arthur-wirjo/ICE_end-of-arm_tooling_controller/BOM_and_Schematics/BOM.md

### EOAT Controller Board BOM

| Category | Description / Value | Manufacturer & Part Number | LCSC / Part ID | Designator | Qty |
| :--- | :--- | :--- | :--- | :--- | :--- |
| **Resistors** | 100Ω, 0603, 1%, 100mW | FOJAN FRC0603F1000TS | C2906981 | R11, R12, R18, R24 | 4 |
| | 1kΩ, 0603, 1%, 100mW | FOJAN FRC0603F1001TS | C2907002 | R1, R2, R6–R9, R19, R20, R29–R31 | 11 |
| | 5.1kΩ, 0805, 1%, 125mW | FOJAN FRC0805F5101TS | C2907269 | R3, R4, R17, R32 | 4 |
| | 10kΩ, 0603, 1%, 100mW | FOJAN FRC0603F1002TS | C2906982 | R13, R14, R21, R33 | 4 |
| | 13.3kΩ, 0603, 1%, 100mW | FOJAN FRC0603F1332TS | C2933140 | R16, R28 | 2 |
| | 100kΩ, 0603, 1%, 100mW | FOJAN FRC0603F1003TS | C2906980 | R5, R10, R15, R22, R23, R26, R27 | 7 |
| | 0.05Ω, 1206, 1%, 1W (Shunt) | FOJAN FRM121WFR050TM | C7467249 | R25 | 1 |
| **Capacitors** | 100nF, 0603, 50V, X7R, 10% | FOJAN FCC0603B104K500CT | C5137636 | C2–C4, C8, C9, C11–C15, C18 | 11 |
| | 1uF, 0603, 25V, X7R, 10% | Samsung Electro-Mechanics CL10B105KA8NNNC | C29936 | C19, C20 | 2 |
| | 4.7uF, 0805, 25V, X7R, 10% | Samsung Electro-Mechanics CL21B475KAFNNNE | C98195 | C6 | 1 |
| | 10uF, 1206, 50V, X7R, 10% | Samsung Electro-Mechanics CL31B106KBHNNNE | C89632 | C1, C10 | 2 |
| | 22uF, 1206, 35V, X5R, 20% | FOJAN FCC1206X226M350HT | C46635923 | C5, C7, C16, C17 | 4 |
| **Inductors** | 15uH, 7.5x6.8mm, 5A, 5.5A (Isat), 54mΩ | FANGCHENG FCH0650-150M | C20415538 | L1, L2 | 2 |
| **Diodes & LEDs** | TVS Diode, Bidirectional, VRWM=26V, Vc=42.1V | Littelfuse SMBJ26CA | C83332 | D11 | 1 |
| | Schottky Diode, 60V, 5A | MDD SS56 | C65009 | D5, D6 | 2 |
| | Red LED, 0603, Vf=2.3V, 20mA, 225mcd | XINGLIGHT XL-1608SURC-06 | C965799 | D7 | 1 |
| | Green LED, 0603, Vf=2.7~3.2V, 25mA, 358mcd | YONGYUTAI YLED0603G | C19273151 | D8, D9, D10, D12 | 4 |
| | Blue LED, 0603, Vf=2.6~3.3V, 5mA, 300mcd | XINGLIGHT XL-1608UBC-06A | C7371904 | D1, D2, D3, D4 | 4 |
| **ICs** | Microcontroller | ST STM32G030F6P6TR | C529330 | U7 | 1 |
| | Buck Converter | TI LMR16030SDDAR | C136648 | U1, U8 | 2 |
| | LDO | MICRONE ME6211A33PG-N | C236673 | U10 | 1 |
| | Optocoupler | TOSHIBA TLP291(GB-TP,SE) | C55144 | U2, U3, U4, U5 | 4 |
| | Voltage Translator | TI SN74LVC1T45DBVR | C7843 | U6 | 1 |
| | Current Sense Amplifier | TI INA180A1IDBVR | C122228 | U9 | 1 |
| **Connectors** | JST-XH 6-pin | JST S6B-XH-SM4-TB(LF)(SN) | - | - | 1 |
| | ST-Link 2.54mm 5-pin | 1x5P 2.54mm Pin Header | - | - | 1 |
| | PWM Servo Output 2.54mm 3-pin | 1x3P 2.54mm Pin Header | - | - | 1 |
| | Digital Servo Output Molex 3-pin | Hongxing HX25003-3WAP | C442327 | - | 1 |
| **Switches** | MCU nRST and BOOT0 Tactile Buttons | XKB Connection TS-1187A-B-A-B | C318884 | - | 2 |

### Off-Board Components (Cables)

| Category | Description / Value | Qty |
| :--- | :--- | :--- |
| **Cables** | M8 6-pin Male Aviation Connector Cable | 1 |
| | XH 2.54mm pitch single-sided, 22AWG Cable | 1 |
