arthur-wirjo/ICE_end-of-arm_tooling_controller/BOM_and_Schematics/ICE_EOAT_Controller_PCB.csv

Reference | Qty | Value | Description | Manufacturer | MPN | LCSC | Footprint
C1, C10 | 2 | 10uF | 1206, 50V, X7R, 10% | Samsung Electro-Mechanics | CL31B106KBHNNNE | C89632 | C_1206_3216Metric
C2, C3, C4, C8, C9, C11, C12, C13, C14, C15, C18 | 11 | 100nF | 0603, 50V, X7R, 10% | FOJAN | FCC0603B104K500CT | C5137636 | C_0603_1608Metric
C5, C7, C16, C17 | 4 | 22uF | 1206, 35V, X5R, 20% | FOJAN | FCC1206X226M350HT | C46635923 | C_1206_3216Metric
C6 | 1 | 4.7uF | 0805, 25V, X7R, 10% | Samsung Electro-Mechanics | CL21B475KAFNNNE | C98195 | C_0805_2012Metric
C19, C20 | 2 | 1uF | 0603, 25V, X7R, 10% | Samsung Electro-Mechanics | CL10B105KA8NNNC | C29936 | C_0603_1608Metric
CN1 | 1 | HX25003-3WAP | Digital Servo Output 3-Pin Right-Angle Header, 2.50mm Pitch, THT | Hongxing | HX25003-3WAP | C442327 | MOLEX_CONN-TH_3P-P2.50_HX25003-3WAP
D1, D2, D3, D4 | 4 | Blue | Blue SMD LED, 0603, Vf=2.6~3.3V, 5mA, 300mcd | XINGLIGHT | XL-1608UBC-06A | C7371904 | LED_0603_1608Metric
D5, D6 | 2 | SS56 | Schottky Diode, 60V, 5A, SMA | MDD | SS56 | C65009 | Schottky_SMA_L4.3-W2.6-LS5.2-RD
D7 | 1 | Red | Red SMD LED, 0603, Vf=2.3V, 20mA, 225mcd | XINGLIGHT | XL-1608SURC-06 | C965799 | LED_0603_1608Metric
D8, D9, D10, D12 | 4 | Green | Green SMD LED, 0603, Vf=2.7~3.2V, 25mA, 358mcd | YONGYUTAI | YLED0603G | C19273151 | LED_0603_1608Metric
D11 | 1 | SMBJ26CA | TVS Diode, Bidirectional, VRWM=26V, Vc=42.1V, DO-214AA (SMB) | Littelfuse | SMBJ26CA | C83332 | TVS_SMB_L4.6-W3.6-LS5.3-BI
J1 | 1 | S6B-XH-SM4-TB(LF)(SN) | JST-XH 6-Pin Male Header, Right-Angle SMD | JST | S6B-XH-SM4-TB(LF)(SN) | - | JST_XH_CONN_S6B-XH-SM4-TB_JST
J2 | 1 | 2.54mm 5-pin | ST-Link 1x5P 2.54mm Pitch Male Pin Header, Horizontal | Generic | - | - | PinHeader_1x05_P2.54mm_Horizontal
J3 | 1 | 2.54mm 3-pin | PWM Servo Output 1x3P 2.54mm Pitch Male Pin Header, Horizontal | Generic | - | - | PinHeader_1x03_P2.54mm_Horizontal
L1, L2 | 2 | 15uH | Shielded Power Inductor, 7.5x6.8mm, 5A, Isat 5.5A, 54mΩ | FANGCHENG | FCH0650-150M | C20415538 | INDUCTOR_IND-SMD_L7.6-W7.0
R1, R2, R6, R7, R8, R9, R19, R20, R29, R30, R31 | 11 | 1kΩ | 0603, 1%, 100mW | FOJAN | FRC0603F1001TS | C2907002 | R_0603_1608Metric
R3, R4, R17, R32 | 4 | 5.1kΩ | 0805, 1%, 125mW | FOJAN | FRC0805F5101TS | C2907269 | R_0805_2012Metric
R5, R10, R15, R22, R23, R26, R27 | 7 | 100kΩ | 0603, 1%, 100mW | FOJAN | FRC0603F1003TS | C2906980 | R_0603_1608Metric
R11, R12, R18, R24 | 4 | 100Ω | 0603, 1%, 100mW | FOJAN | FRC0603F1000TS | C2906981 | R_0603_1608Metric
R13, R14, R21, R33 | 4 | 10kΩ | 0603, 1%, 100mW | FOJAN | FRC0603F1002TS | C2906982 | R_0603_1608Metric
R16, R28 | 2 | 13.3kΩ | 0603, 1%, 100mW | FOJAN | FRC0603F1332TS | C2933140 | R_0603_1608Metric
R25 | 1 | 0.05Ω | Current Sense Shunt Resistor, 1206, 1%, 1W | FOJAN | FRM121WFR050TM | C7467249 | Shunt_R1206
SW1, SW2 | 2 | TS-1187A-B-A-B | MCU nRST and BOOT0 Tactile Switch, SPST, SMD-4P, 5.1x5.1x1.5mm | XKB Connection | TS-1187A-B-A-B | C318884 | BUTTON_SW-SMD_4P-L5.1-W5.1
U1, U8 | 2 | LMR16030SDDAR | 60V, 3A Step-Down Buck Converter, HSOIC-8-EP | Texas Instruments | LMR16030SDDAR | C136648 | BUCK_SOIC-8_EP
U2, U3, U4, U5 | 4 | TLP291(GB-TP,SE) | Optocoupler, Phototransistor Output, 3.75kVrms, SOP-4 | TOSHIBA | TLP291(GB-TP,SE) | C55144 | Optocoupler_SOP-4
U6 | 1 | SN74LVC1T45DBVR | Single-Bit Dual-Supply Bus Transceiver / Level Shifter, SOT-23-6 | Texas Instruments | SN74LVC1T45DBVR | C7843 | Voltage_Translator_SOT-23-6
U7 | 1 | STM32G030F6P6TR | 32-bit ARM Cortex-M0+ MCU, 64MHz, 32KB Flash, TSSOP-20 | STMicroelectronics | STM32G030F6P6TR | C529330 | MCU_TSSOP-20
U9 | 1 | INA180A1IDBVR | Current Sense Amplifier, 20V/V Gain, SOT-23-5 | Texas Instruments | INA180A1IDBVR | C122228 | Amplifier_SOT-23-5
U10 | 1 | ME6211A33PG-N | 3.3V LDO Voltage Regulator, 500mA, SOT-89 | MICRONE | ME6211A33PG-N | C236673 | LDO_SOT-89
