arthur-wirjo/ICE_end-of-arm_tooling_controller/Component_EDA_Models/JST_XH_S6B-XH-SM4-TB-LF-SN/S6B-XH-SM4-TB-LF--SN---3DModel-STEP-56544.STEP

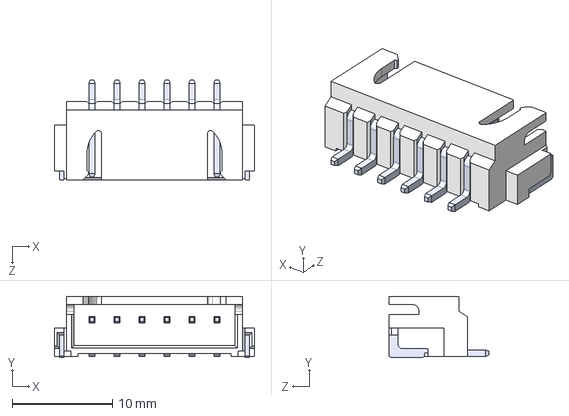
[picture p1: CAD file, 2026-11-08]
Component_EDA_Models/JST_XH_S6B-XH-SM4-TB-LF-SN/S6B-XH-SM4-TB-LF--SN---3DModel-STEP-56544.STEP
20.0 x 6.12 x 10.0 mm
SxB-XH-SM4-TB_6
pin^SxB-XH-SM4-TB Ass x 6
