arthur-wirjo/ICE_end-of-arm_tooling_controller/BOM_and_Schematics/ICE_EOAT_Controller_PCB.pdf

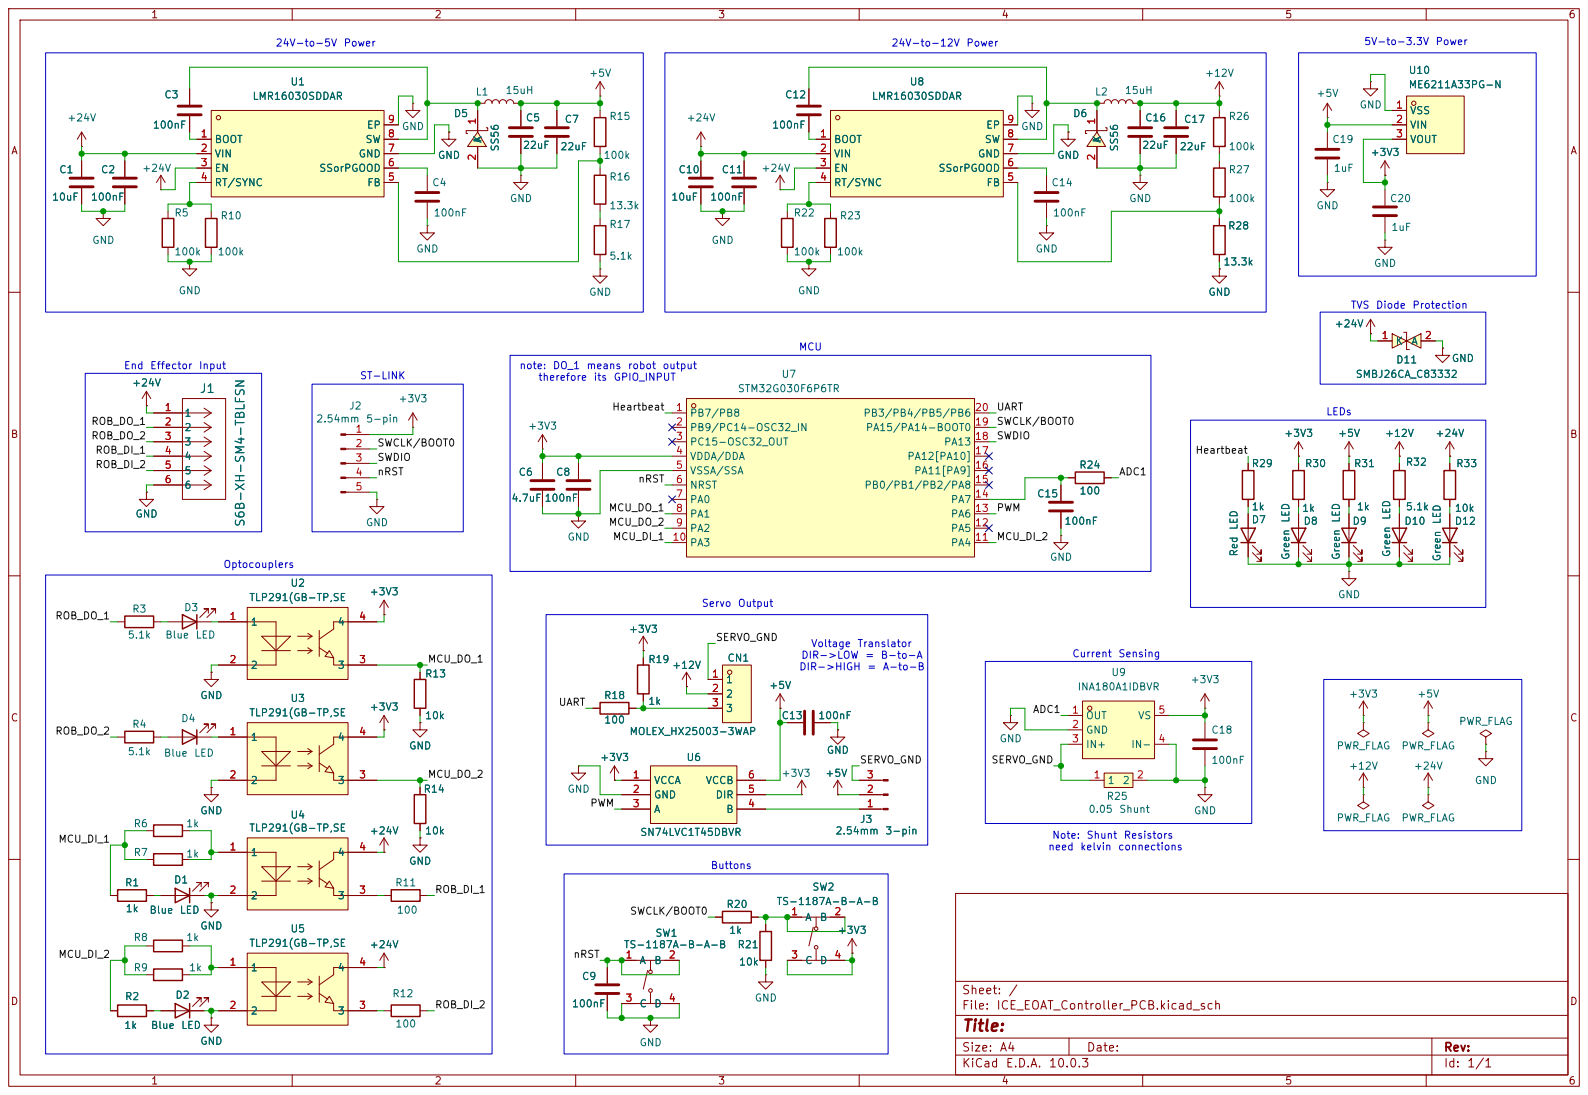
[picture p2: page 1]

TLP291(GB-TP,SE GND

Size: A4 | Rev:
KiCad E.D.A. 10.0.3 | Id: 1/1
