arthur-wirjo/ICE_end-of-arm_tooling_controller/ICE_EOAT_Controller_PCB/ICE_EOAT_Controller_PCB.kicad_pcb

## KiCad design ICE_EOAT_Controller_PCB/ICE_EOAT_Controller_PCB.kicad_pcb (2026-11-08)

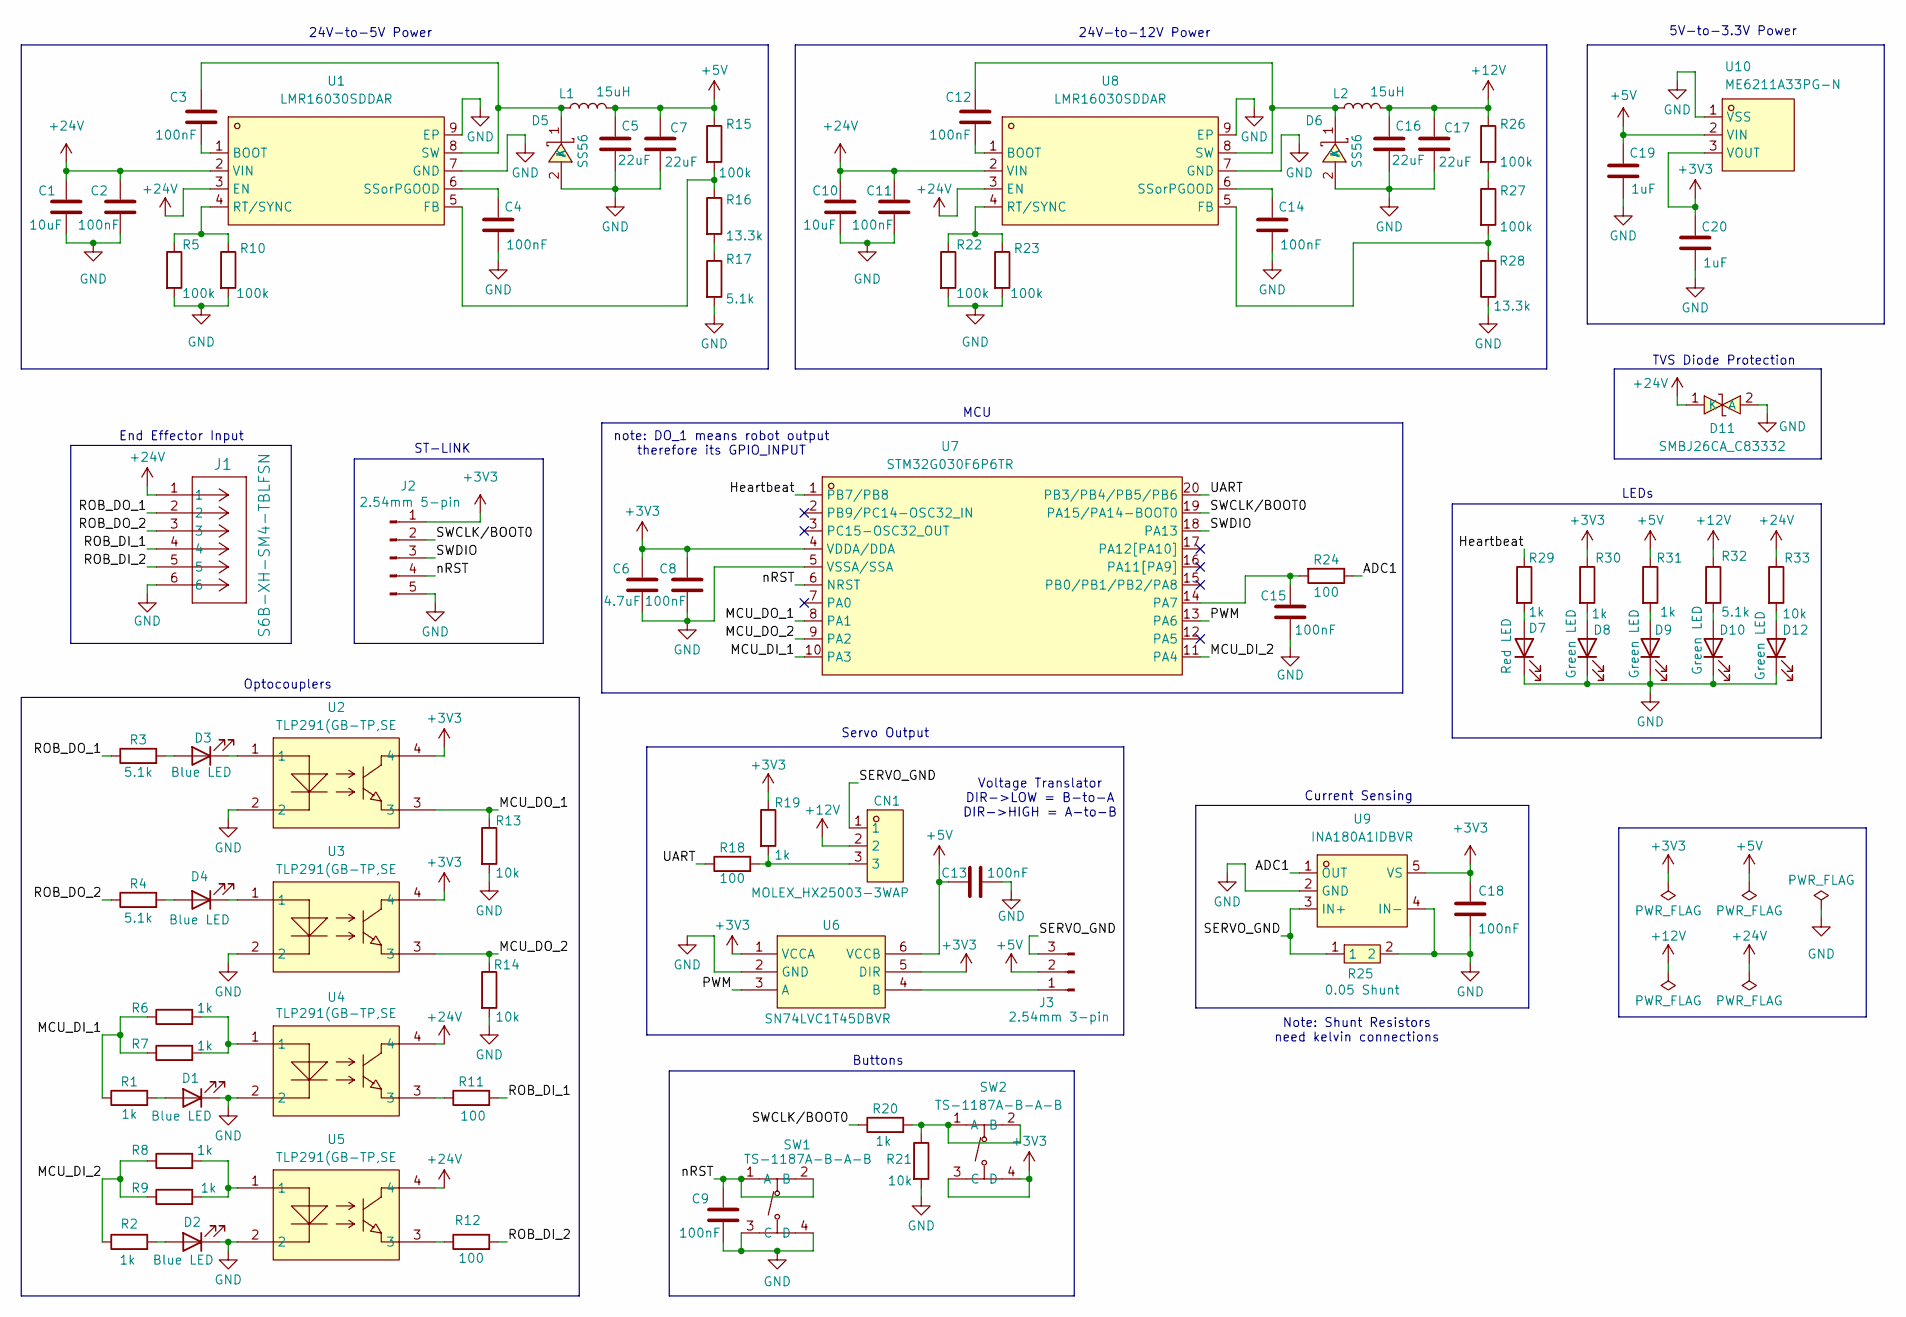
[picture p3: schematic ICE_EOAT_Controller_PCB.kicad_sch]

Parts:
C1, C10: 10uF; C_1206_3216Metric_Pad1.33x1.80mm_HandSolder
C2, C3, C4, C8, C9, C11, C12, C13, C14, C15, C18: 100nF; C_0603_1608Metric_Pad1.08x0.95mm_HandSolder
C5, C7, C16, C17: 22uF; C_1206_3216Metric_Pad1.33x1.80mm_HandSolder
C6: 4.7uF; C_0805_2012Metric_Pad1.18x1.45mm_HandSolder
C19, C20: 1uF; C_0603_1608Metric_Pad1.08x0.95mm_HandSolder
CN1: MOLEX_HX25003-3WAP; MOLEX_CONN-TH_3P-P2.50_HX25003-3WAP; MPN HX25003-3WAP; LCSC Part C442327
D1, D2, D3, D4: Blue LED; LED_0603_1608Metric_Pad1.05x0.95mm_HandSolder
D5, D6: SS56; Schottky_SMA_L4.3-W2.6-LS5.2-RD; MPN SS56; LCSC Part C65009
D7: Red LED; LED_0603_1608Metric_Pad1.05x0.95mm_HandSolder
D8, D9, D10, D12: Green LED; LED_0603_1608Metric_Pad1.05x0.95mm_HandSolder
D11: SMBJ26CA_C83332; TVS_SMB_L4.6-W3.6-LS5.3-BI; MPN SMBJ26CA; LCSC Part C83332
J1: S6B-XH-SM4-TBLFSN; JST_XH_CONN_S6B-XH-SM4-TB_JST
J2: 2.54mm 5-pin; PinHeader_1x05_P2.54mm_Horizontal
J3: 2.54mm 3-pin; PinHeader_1x03_P2.54mm_Horizontal
L1, L2: 15uH; INDUCTOR_IND-SMD_L7.6-W7.0
R1, R2, R6, R7, R8, R9, R19, R20, R29, R30, R31: 1k; R_0603_1608Metric_Pad0.98x0.95mm_HandSolder
R3, R4, R17, R32: 5.1k; R_0805_2012Metric_Pad1.20x1.40mm_HandSolder
R5, R10, R15, R22, R23, R26, R27: 100k; R_0603_1608Metric_Pad0.98x0.95mm_HandSolder
R11, R12, R18, R24: 100; R_0603_1608Metric_Pad0.98x0.95mm_HandSolder
R13, R14, R21, R33: 10k; R_0603_1608Metric_Pad0.98x0.95mm_HandSolder
R16, R28: 13.3k; R_0603_1608Metric_Pad0.98x0.95mm_HandSolder
R25: 0.05 Shunt; Shunt_R1206; MPN FRM121WFR050TM; LCSC Part C7467249
SW1, SW2: TS-1187A-B-A-B; BUTTON_SW-SMD_4P-L5.1-W5.1-P3.70-LS6.5-TL_H1.5; MPN TS-1187A-B-A-B; LCSC Part C318884
U1, U8: LMR16030SDDAR; BUCK_SOIC-8_L4.9-W3.9-P1.27-LS6.0-BL-EP2.3; MPN LMR16030SDDAR; LCSC Part C136648
U2, U3, U4, U5: TLP291(GB-TP,SE; Optocoupler_SOP-4_L4.4-W2.8-P1.27-LS7.0-BR; MPN TLP291(GB-TP,SE; LCSC Part C55144
U6: SN74LVC1T45DBVR; Voltage_Translator_SOT-23-6_L2.9-W1.6-P0.95-LS2.8-BR; MPN SN74LVC1T45DBVR; LCSC Part C7843
U7: STM32G030F6P6TR; MCU_TSSOP-20_L6.5-W4.4-P0.65-LS6.4-BL; MPN STM32G030F6P6TR; LCSC Part C529330
U9: INA180A1IDBVR; Amplifier_SOT-23-5_L3.0-W1.7-P0.95-LS2.8-BR; MPN INA180A1IDBVR; LCSC Part C122228
U10: ME6211A33PG-N; LDO_SOT-89_L4.5-W2.5-P1.50-LS4.2-BR; MPN ME6211A33PG-N; LCSC Part C236673

Connections:
+3V3: C6.1, C8.1, C18.1, C20.1, J2.1, R19.1, R30.1, SW2.3 (C), SW2.4 (D), U2.4, U3.4, U6.1 (VCCA), U6.5 (DIR), U7.4 (VDDA/DDA), U9.5 (VS), U10.3 (VOUT)
+5V: C5.1, C7.1, C13.1, C19.1, J3.2, L1.2, R15.1, R31.1, U6.6 (VCCB), U10.2 (VIN)
+12V: C16.1, C17.1, CN1.2, L2.2, R26.1, R32.1
+24V: C1.1, C2.1, C10.1, C11.1, D11.1 (K), J1.1, R33.1, U1.2 (VIN), U1.3 (EN), U4.4, U5.4, U8.2 (VIN), U8.3 (EN)
/ADC1: R24.1, U9.1 (OUT)
/Heartbeat: R29.1, U7.1 (PB7/PB8)
/MCU_DI_1: R1.1, R6.1, R7.1, U7.10 (PA3)
/MCU_DI_2: R2.1, R8.1, R9.1, U7.11 (PA4)
/MCU_DO_1: R13.1, U2.3, U7.8 (PA1)
/MCU_DO_2: R14.1, U3.3, U7.9 (PA2)
/PWM: U6.3 (A), U7.13 (PA6)
/ROB_DI_1: J1.4, R11.2
/ROB_DI_2: J1.5, R12.2
/ROB_DO_1: J1.2, R3.1
/ROB_DO_2: J1.3, R4.1
/SERVO_GND: CN1.1, J3.3, R25.1, U9.3 (IN+)
/SWCLK/BOOT0: J2.2, R20.1, U7.19 (PA15/PA14-BOOT0)
/SWDIO: J2.3, U7.18 (PA13)
/UART: R18.1, U7.20 (PB3/PB4/PB5/PB6)
/nRST: C9.1, J2.4, SW1.1 (A), SW1.2 (B), U7.6 (NRST)
GND: C1.2, C2.2, C4.2, C5.2, C6.2, C7.2, C8.2, C9.2, C10.2, C11.2, C13.2, C14.2, C15.2, C16.2, C17.2, C18.2, C19.2, C20.2, D1.1 (K), D2.1 (K), D5.2 (A), D6.2 (A), D7.1 (K), D8.1 (K), D9.1 (K), D10.1 (K), D11.2 (A), D12.1 (K), J1.6, J1.7, J1.8, J2.5, R5.2, R10.2, R13.2, R14.2, R17.2, R21.2, R22.2, R23.2, R25.2, R28.1, SW1.3 (C), SW1.4 (D), U1.7 (GND), U1.9 (EP), U2.2, U3.2, U4.2, U5.2, U6.2 (GND), U7.5 (VSSA/SSA), U8.7 (GND), U8.9 (EP), U9.2 (GND), U9.4 (IN-), U10.1 (VSS)
unnamed: CN1.3, R18.2, R19.2
unnamed: D1.2 (A), R1.2
unnamed: D2.2 (A), R2.2
unnamed: D3.2 (A), R3.2
unnamed: D3.1 (K), U2.1
unnamed: D4.2 (A), R4.2
unnamed: D4.1 (K), U3.1
unnamed: C3.1, D5.1 (K), L1.1, U1.8 (SW)
unnamed: C12.1, D6.1 (K), L2.1, U8.8 (SW)
unnamed: D7.2 (A), R29.2
unnamed: D8.2 (A), R30.2
unnamed: D9.2 (A), R31.2
unnamed: D10.2 (A), R32.2
unnamed: D12.2 (A), R33.2
unnamed: J3.1, U6.4 (B)
unnamed: R6.2, R7.2, U4.1
unnamed: R8.2, R9.2, U5.1
unnamed: R11.1, U4.3
unnamed: R12.1, U5.3
unnamed: R16.2, R17.1
unnamed: R26.2, R27.1
unnamed: R20.2, R21.1, SW2.1 (A), SW2.2 (B)
unnamed: C3.2, U1.1 (BOOT)
unnamed: R15.2, R16.1, U1.5 (FB)
unnamed: R5.1, R10.1, U1.4 (RT/SYNC)
unnamed: C4.1, U1.6 (SSorPGOOD)
unnamed: C15.1, R24.2, U7.14 (PA7)
unnamed: C12.2, U8.1 (BOOT)
unnamed: R27.2, R28.2, U8.5 (FB)
unnamed: R22.1, R23.1, U8.4 (RT/SYNC)
unnamed: C14.1, U8.6 (SSorPGOOD)

Notes on the sheet:
Voltage Translator DIR->LOW = B-to-A DIR->HIGH = A-to-B
TVS Diode Protection
ST-LINK
Buttons
MCU
note: DO_1 means robot output therefore its GPIO_INPUT
Optocouplers
5V-to-3.3V Power
End Effector Input
Servo Output
LEDs
Note: Shunt Resistors need kelvin connections
24V-to-5V Power
24V-to-12V Power
Current Sensing

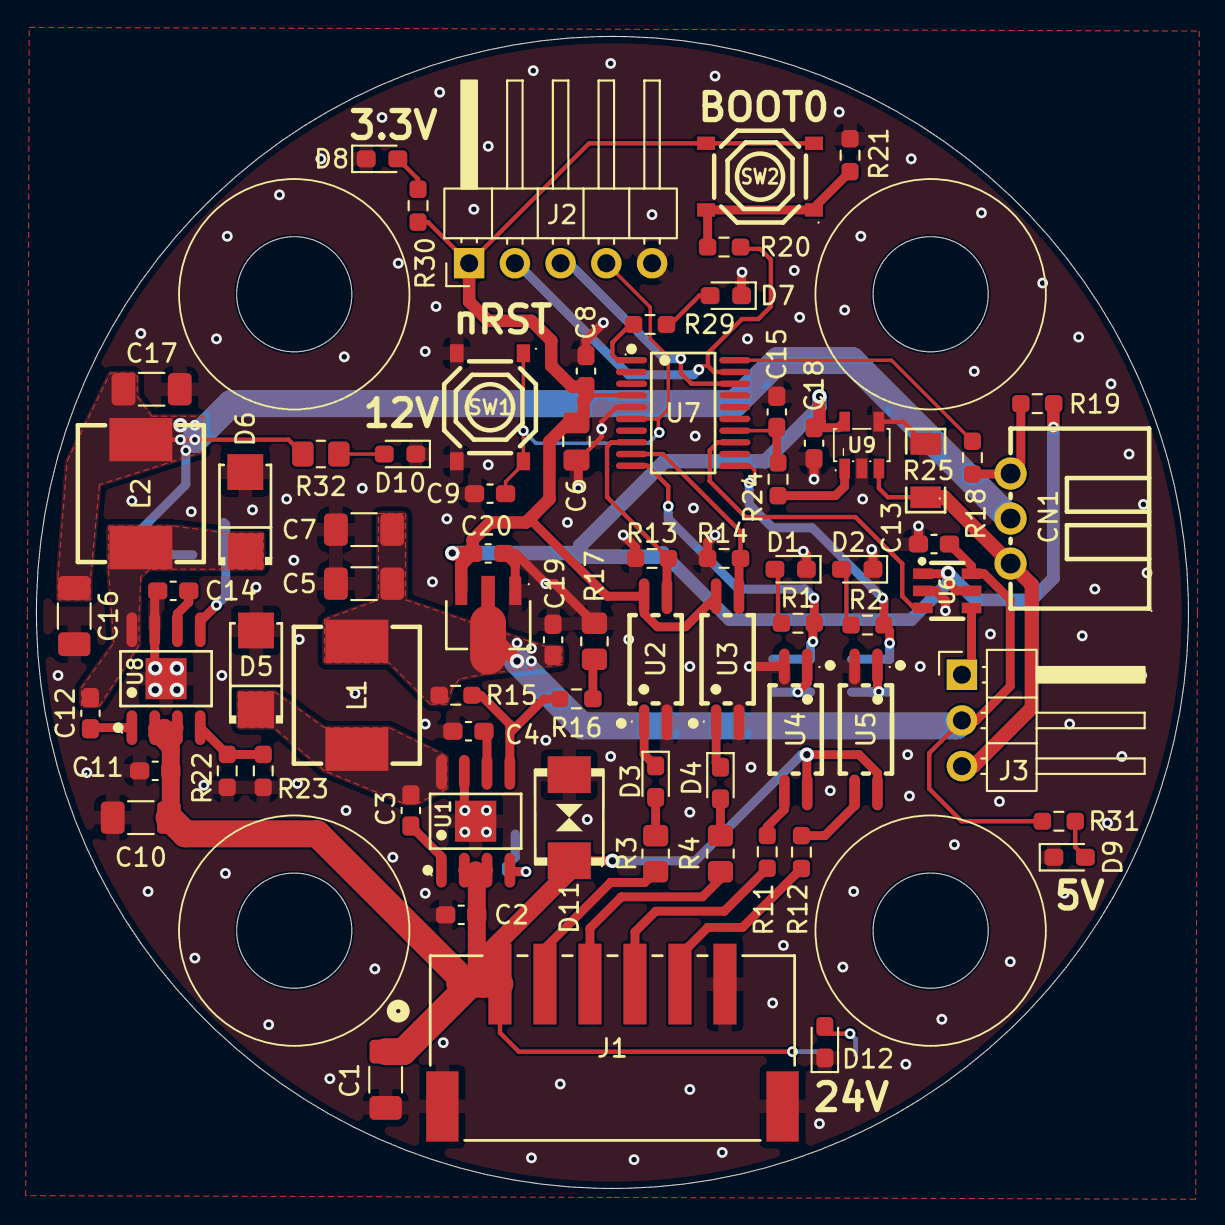
[picture p4: board ICE_EOAT_Controller_PCB.kicad_pcb from above]

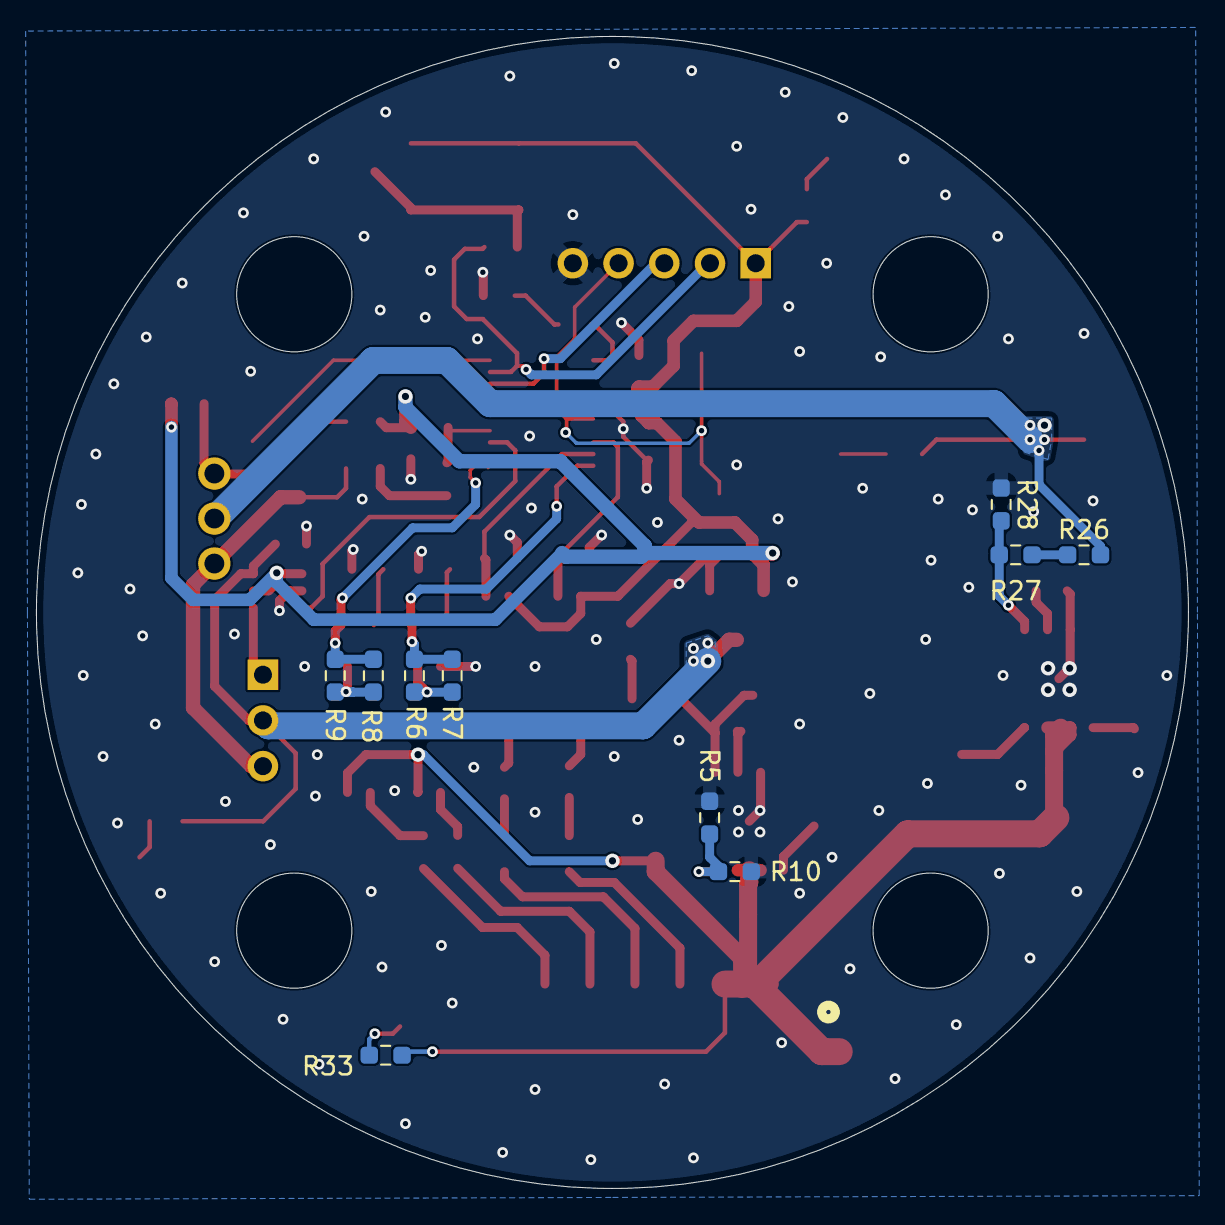
[picture p5: board ICE_EOAT_Controller_PCB.kicad_pcb from below]

Board: 4 copper layers, 64.0 x 64.0 mm, 83 parts (10 on the bottom side), 52 nets.
