arthur-wirjo/ICE_end-of-arm_tooling_controller/Firmware/Firmware.ioc

Mcu.UserName=STM32G030F6Px
PA1.GPIO_Label=D1_OUT
PA1.Signal=GPIO_Input
PA13.Signal=SYS_SWDIO
PA14-BOOT0.Signal=SYS_SWCLK
PA2.GPIO_Label=D2_OUT
PA2.Signal=GPIO_Input
PA3.GPIO_Label=D1_IN
PA3.Signal=GPIO_Output
PA4.GPIO_Label=D2_IN
PA4.Signal=GPIO_Output
PA6.Signal=S_TIM3_CH1
PA7.Signal=ADC1_IN7
PB6.Signal=USART1_TX
PB8.GPIO_Label=HEARTBEAT
PB8.Signal=GPIO_Output
