arthur-wirjo/ICE_end-of-arm_tooling_controller/(commit log)

2026-11-04 initial PCB commit
    [ICE_EOAT_Controller_PCB.kicad_pcb, ICE_EOAT_Controller_PCB.kicad_sch]
2026-11-06 schematic done and components sourced
    [ICE_EOAT_Controller_PCB.kicad_pcb, ICE_EOAT_Controller_PCB.kicad_sch]
2026-11-06 components in layout organized, checkpoint for if need re-layout
    [ICE_EOAT_Controller_PCB.kicad_pcb]
2026-11-06 component placement done
    [ICE_EOAT_Controller_PCB.kicad_pcb]
2026-11-07 layout all done
    [ICE_EOAT_Controller_PCB.kicad_pcb]
2026-11-07 added gerber files
    [ICE_EOAT_Controller_PCB-B_Cu.gbl, ICE_EOAT_Controller_PCB-B_Mask.gbs, ICE_EOAT_Controller_PCB-B_Paste.gbp, ICE_EOAT_Controller_PCB-B_Silkscreen.gbo, ICE_EOAT_Controller_PCB-Edge_Cuts.gm1, ICE_EOAT_Controller_PCB-F_Cu.gtl, ICE_EOAT_Controller_PCB-F_Mask.gts, ICE_EOAT_Controller_PCB-F_Paste.gtp]
2026-11-08 minor PCB step file adjustments
    [ICE_EOAT_Controller_PCB.kicad_pcb, S6B-XH-SM4-TB-LF--SN---3DModel-STEP-56544.STEP]
2026-11-08 added BOM_and_Schematics directory, added schematics pdf, and fixed small resistor R28 footprint mistake
    [ICE_EOAT_Controller_PCB-B_Cu.gbl, ICE_EOAT_Controller_PCB-B_Mask.gbs, ICE_EOAT_Controller_PCB-B_Paste.gbp, ICE_EOAT_Controller_PCB-B_Silkscreen.gbo, ICE_EOAT_Controller_PCB-Edge_Cuts.gm1, ICE_EOAT_Controller_PCB-F_Cu.gtl, ICE_EOAT_Controller_PCB-F_Mask.gts, ICE_EOAT_Controller_PCB-F_Paste.gtp]
